BenBergman/can-controller/board_photo_back_2011-01-25.png

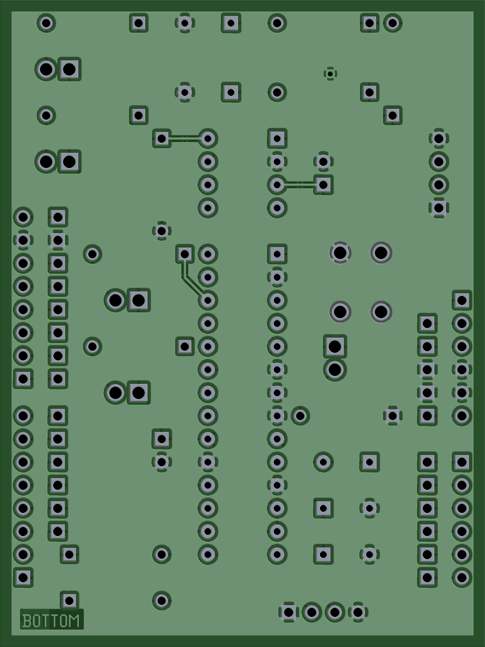
board_photo_back_2011-01-25.png
