BenBergman/can-controller/can-shield_schematic_light.png

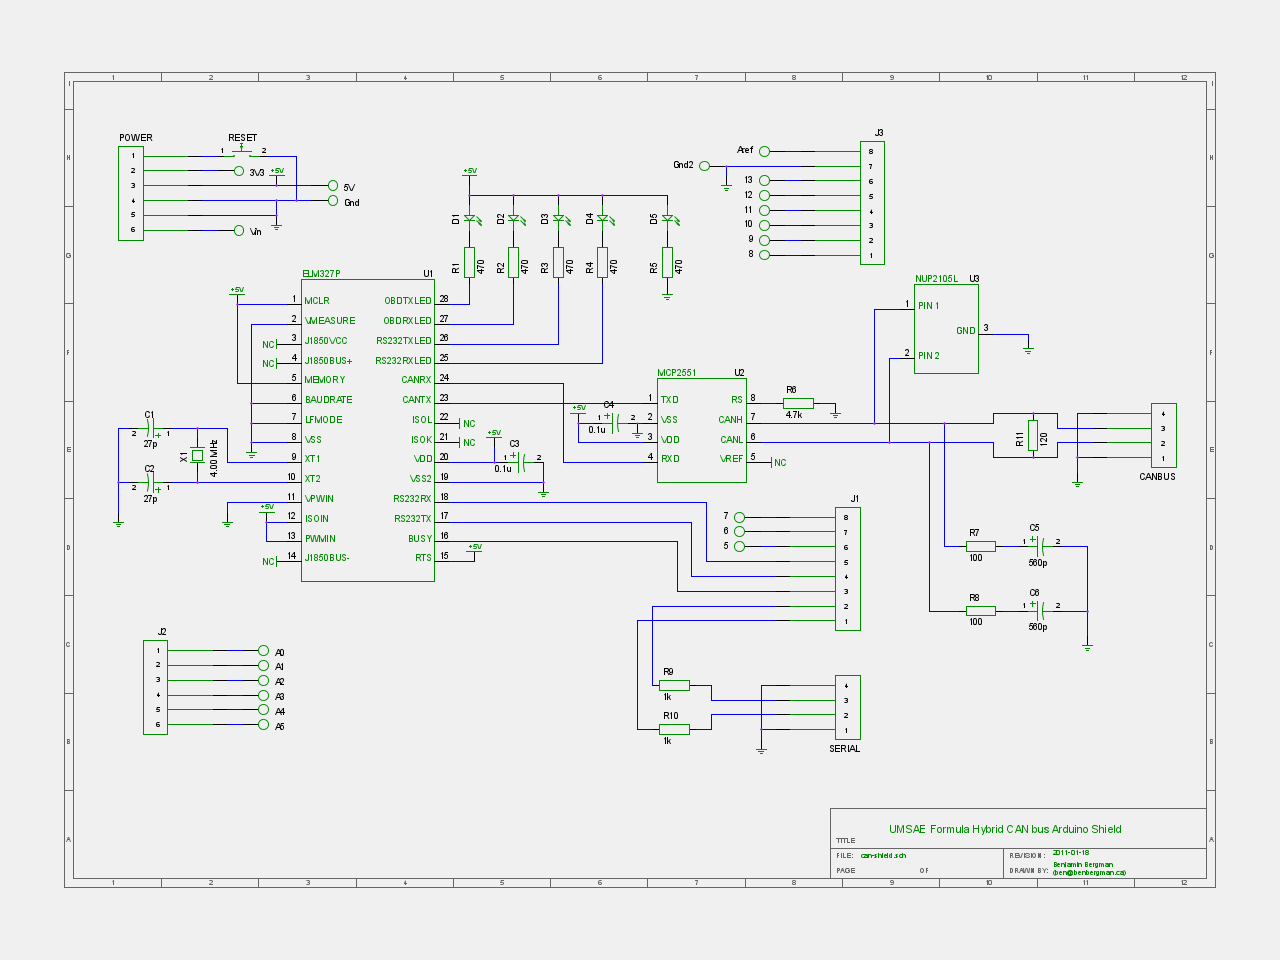
can-shield_schematic_light.png
