BenBergman/can-controller/(list of files, drawings)

Other design files:
board.pcb
