BenBergman/can-controller/(commit log)

2011-01-26 Added reset pin header
    [board.pcb]
2011-02-01 Added silk screen to back with copyright and rev
    [board.pcb]
2011-02-01 Changed IC drill size as per manufacturer recommendation
    [board.pcb]
2011-02-04 Increased drill size for C1, C2, C5, C6, and X1
    [board.pcb]
2011-02-14 Shrunk LED holes to be more reasonable
    [board.pcb]
2011-02-25 Added comments to APC vendor file Their drill sizes are BEFORE plating, unlike most circuit houses. This was the cause of the hole size problem. Added comments to reflect this.
